pluggee/R1100/README.md

# R1100
C.H.I.P. Pro Interposer with Host USB 2.0
