pluggee/R1100/pcb/R1100.pdf

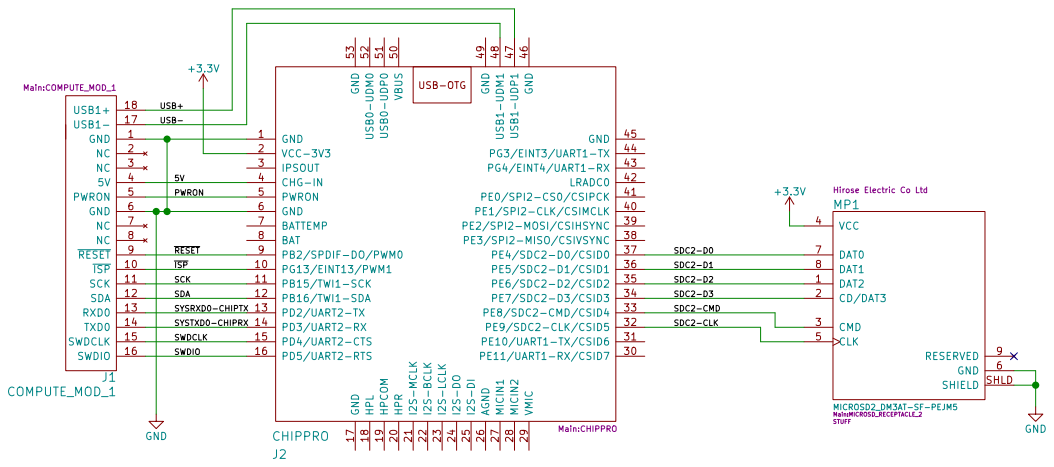
[picture p1: page 1]

5V
PWRON

MICROSD2_DM3AT-SF-PEJM5 Main:MICROSD_RECEPTACLE_2 Hirose Electric Co Ltd

ISP
SCK
SDA
SYSRXD0-CHIPTX
SYSTXD0-CHIPRX
SWDCLK
SWDIO

File: R1100.sch Sheet: /
Id: 1/1 Title: R1100 C.H.I.P. Pro Interposer with Host USB 2.0
