pluggee/R1100/(threads)

Thread 1 (2017-06-30):

Features for v1.2

pluggee, 2017-06-30:
- hook SD card through data interface (not SPI)
- fix card detection problem, select which pin to use as interrupt
- add a header pin to UART1 for debug interface
