pluggee/R1100/(commit log)

2017-04-03 added silk screen art
    [R1100-B.Cu.gbr, R1100-B.Mask.gbr, R1100-B.Paste.gbr, R1100-B.SilkS.gbr, R1100-Edge.Cuts.gbr, R1100-F.Cu.gbr, R1100-F.Mask.gbr, R1100-F.Paste.gbr]
2017-04-06 corrected signalling to SWD
    [R1100-B.Cu.gbr, R1100-B.Mask.gbr, R1100-B.Paste.gbr, R1100-B.SilkS.gbr, R1100-Edge.Cuts.gbr, R1100-F.Cu.gbr, R1100-F.Mask.gbr, R1100-F.Paste.gbr]
2017-06-04 releasing 1.1, changed USB to USB1 instead of USB0
    [R1100-B.Cu.gbr, R1100-B.Mask.gbr, R1100-B.Paste.gbr, R1100-B.SilkS.gbr, R1100-Edge.Cuts.gbr, R1100-F.Cu.gbr, R1100-F.Mask.gbr, R1100-F.Paste.gbr]
2017-06-18 releasing v1.2 with micro SD card slot
    [R1100-B.Cu.gbr, R1100-B.Mask.gbr, R1100-B.Paste.gbr, R1100-B.SilkS.gbr, R1100-Edge.Cuts.gbr, R1100-F.Cu.gbr, R1100-F.Mask.gbr, R1100-F.Paste.gbr]
2017-08-23 updated interposer to connect microSD card to SD lines
    [R1100-B.Cu.gbr, R1100-B.Mask.gbr, R1100-B.Paste.gbr, R1100-B.SilkS.gbr, R1100-Edge.Cuts.gbr, R1100-F.Cu.gbr, R1100-F.Mask.gbr, R1100-F.Paste.gbr]
